jcoehoorn/BrickMaker/README.md

# BrickMaker
Generate STL files for Lego-like bricks that can be 3D printed

This is a repository for the OpenSCAD code. The meat of the project is here:  
[ThingiVerse Customizable Lego-like Brick](https://www.thingiverse.com/thing:3424550)

For license information, check the ThingiVerse page. Whatever license is shown there is correct. At the time of this writing, the license is [Creative Commons - Attribution](http://creativecommons.org/licenses/by/3.0/)
