jcoehoorn/BrickMaker/(threads)

Thread 1 (2019-03-06):

Customizer renders skinny studs

jcoehoorn, 2019-03-06:
ThingiVerse Customizer is rendering studs different than OpenSCAD.

The code below somehow produces a stud with a 2 mm diameter in the customizer and 4.825 mm in OpenSCAD.

```
LU = 1.6;
stud_radius_adjustment = -.02;
base_stud_height = 1.8;
stud_height_adjustment = .1;

stud_height = base_stud_height - stud_height_adjustment;
stud_rad = (1.5*LU) - stud_radius_adjustment;

cylinder(stud_height,stud_rad, stud_rad, $fn=40);
```

jcoehoorn, 2019-03-06:
Turns out Customizer wants floats with an absolute value < 1 to have leading zeros. Fix is in.

Closed 2019-03-06.

Thread 2 (2019-07-18):

Make top slimmer for plates

jcoehoorn, 2019-07-18:
When transitioning from the side walls to the top of the brick, the first layer bridging over the empty space can tend to droop a bit. This is fine for bricks, but for plates it means the studs on a piece below may not fit all the way in cleanly. We need to make this top face slimmer (and lift it up by the same amount) so there is space for the studs below. Probably 0.2 mm is enough, and this could be an optional adjustment factor.

Thread 3 (2019-07-18):

Rendering issues in 1x1 plate

jcoehoorn, 2019-07-18:
There are two inner posts in the 1x1 plate, where there should be none. Also, the top overhangs the sides. It's not clear yet whether the it's the sides or top that are calculated wrong.

jcoehoorn, 2020-03-17:
Fixed by commit c789a6791c59f00f81073a15ea5025619c84d1db

Closed 2020-03-17.

Thread 4 (2019-07-18):

Plates should still have ridges inside

jcoehoorn, 2019-07-18:
In real Lego  pieces, the plate pieces do not have the ridges to grab the studs, like the bricks do. But in play testing, my clone plates still need these, or some other alternative in order for the pieces below to snap in and hold effectively.

jcoehoorn, 2019-07-18:
Is this also true for 1xN plates?
What about larger plates, where the ridges are only a small part of the contact with the overall stud? Is the center post maybe the problem instead?

jcoehoorn, 2020-03-17:
Fixed by commit c789a6791c59f00f81073a15ea5025619c84d1db

Closed 2020-03-17.

Thread 5 (2019-07-18):

Improve OpenScad build performance

jcoehoorn, 2019-07-18:
Trying an 8x8 plate, the preview (F5) is fine, but the full F6 render can take a very long time, and eventually seem to get stuck at 984 out of 1000. It did finish after over 3 minutes. A 10x10 plate took over 6 minutes. Smaller pieces are fine, but I want to reduce build times for these larger bricks.

jcoehoorn, 2020-03-17:
Testing this again after the refactor to use modules. It still stalled at 5/1000 and 979/1000. I suspect it will finish if I let it go long enough, but I waited over a minute, which is long enough to know I still have the problem.

jcoehoorn, 2020-03-17:
Further note: the full render did finish just I submitted the previous comment. But I don't know you could go much larger.

Thread 6 (2019-07-18):

Reduce height of ridges

jcoehoorn, 2019-07-18:
On real Lego bricks, the ridges go all the way to the top of the brick. This is not needed. The ridges should only need to go as high as the studs.

While I doubt trimming these tiny ridges will create meaningful filament savings, I do suspect it will noticeably reduce motions while printing the inside walls, and therefore improve print times.

jcoehoorn, 2019-07-18:
Maybe this should be an option? Need some more time to digest this one before making any changes.

I can always implement as an option first, but not expose that option to the ThingiVerse Customizer interface right away.

jcoehoorn, 2020-03-17:
Fixed by commit c789a6791c59f00f81073a15ea5025619c84d1db

Closed 2020-03-17.

Thread 7 (2019-07-18):

Add a color option

jcoehoorn, 2019-07-18:
This is an idea that may never happen, but I could probably add an option for the customizer to set the render color. Of course, this won't matter for the print; it would only be for rendering. And it's easy to paint an STL in other programs, once you have it, but this is one of those things some people might really appreciate.

jcoehoorn, 2020-03-17:
I could also see this being useful for dual-extruder (or more) systems, where you might want to lay out different color pieces.

Thread 8 (2019-07-18):

2x3 bricks have cross-support on 2nd post

jcoehoorn, 2019-07-18:
The 2nd post inside a 2x3 brick has a cross support that does not belong. Real 2x3 bricks don't have this, and since printed PLA pieces already tends to be more rigid than Lego ABS, the extra support will hurt more than it helps.

jcoehoorn, 2020-03-17:
Looking at this again today, I'm tempted to close as "Won't Fix"

Thread 10 (2019-07-19):

Possible rounding error in wall thicknesses

jcoehoorn, 2019-07-19:
In my slicer, if I leave all the default settings alone, I often see a bunch of diagnal movements for the middle line in the walls, instead of a clean line. I can fix this by scaling the piece very slightly (.001%, maybe even less), by adding a very small horizontal expansion value (.0001, maybe even less), or other subtle tweaks.

But I shouldn't have to. I know my nozzle width, and I know the size of the walls. I've confirmed the size of the walls using three different tools (OpenSCAD, MeshMixer, and 3D Builder), and they all report exactly 1.2 mm. I should be three clean lines or 0.4 mm each... but I don't.

Need to track down what causes this, or what adjustment I can make to work around the issue and get good slices out of the gate. Since the slicer engine is a mystery to most everyone, it will likely end up doing the work-around, where I use a value that is intentionally wrong by some very small amount.

jcoehoorn, 2020-03-17:
I think this is probably a bug in Cura, but I'll leave this active until I can prove it.

Thread 12 (2020-03-17):

Default adjustments are still evolving

jcoehoorn, 2020-03-17:
I'm still tweaking adjustments values with almost every print, and therefore new numbers for those constants will tend to sneak in with otherwise unrelated commits. It's bad, I know, and better process could account for this, but for the moment I'm just leaving this as an active issue, to help anyone else watching this project be aware of the problem, until things become more stable.
