jcoehoorn/BrickMaker/(commit log)

2019-02-21 Improve descriptions for ThingiVerse Customizer
    [create_brick.scad]
2019-03-06 Default gapping adjustments
    [create_brick.scad]
2019-03-06 Make inner support post radius depend on outer radius and nozzle size
    [create_brick.scad]
2019-03-06 Post adjustment + comments and short-hand subs
    Added adjustment for post size on 2xN bricks. Also re-read all the comments after a couple weeks and made sure things were clear. In the process found a few places where I should have used the short-hands for certain items.
    [create_brick.scad]
2019-03-06 Fix for support post width with small nozzles
    Since I ask people to lie and use a small nozzle width if they want models to exactly match lego bricks, it's not okay to have things depend *only* on the nozzle width. I did a review and found the support posts on 2xN bricks failed that check. This is now fixed.
    [create_brick.scad]
2019-03-06 Add important reminder about ridges and plates
    I'm done for a while, but I don't want to forget this when I come back:
    Test prints of plates are too loose compared to bricks. Real lego does not use ridges for plates, but I might need to.
    [create_brick.scad]
2019-03-06 Set $fn for 1xN support posts to be divisible by 4.
    [create_brick.scad]
2019-03-06 Add leading zeros to floats with abs() < 1 (fix for issue #1)
    [create_brick.scad]
2020-03-16 Issue 11
    A significant refactor to use more modules. This makes it possible to include the script as part of larger works. For example, you can use it to place studs along the top of another model.
    [create_brick.scad]
2020-03-16 Fix mistake with cross supports for 1xN bricks
    [create_brick.scad]
2020-03-17 Fix for issues 3, 4, and 6
    [create_brick.scad]
2020-03-17 Add support for adjusting the depth of interior ridge
    [create_brick.scad]
2020-03-17 Support using ridges on narrow pieces
    [create_brick.scad]
2020-03-18 Fixed bugs resulting from transition to modules
    Duplicate initialization of some values in LEGO_FULL(), and wasn't properly calling LEGO_FULL(). It seemed to work because the constants were also defined earlier. This should be resolved now.
    [create_brick.scad]
2020-03-18 Removed duplicate code
    [create_brick.scad]
